omesoftwarelab/RobotArmUsingArduinoUno/Waveform_of_collector_emitter_voltage.jpg

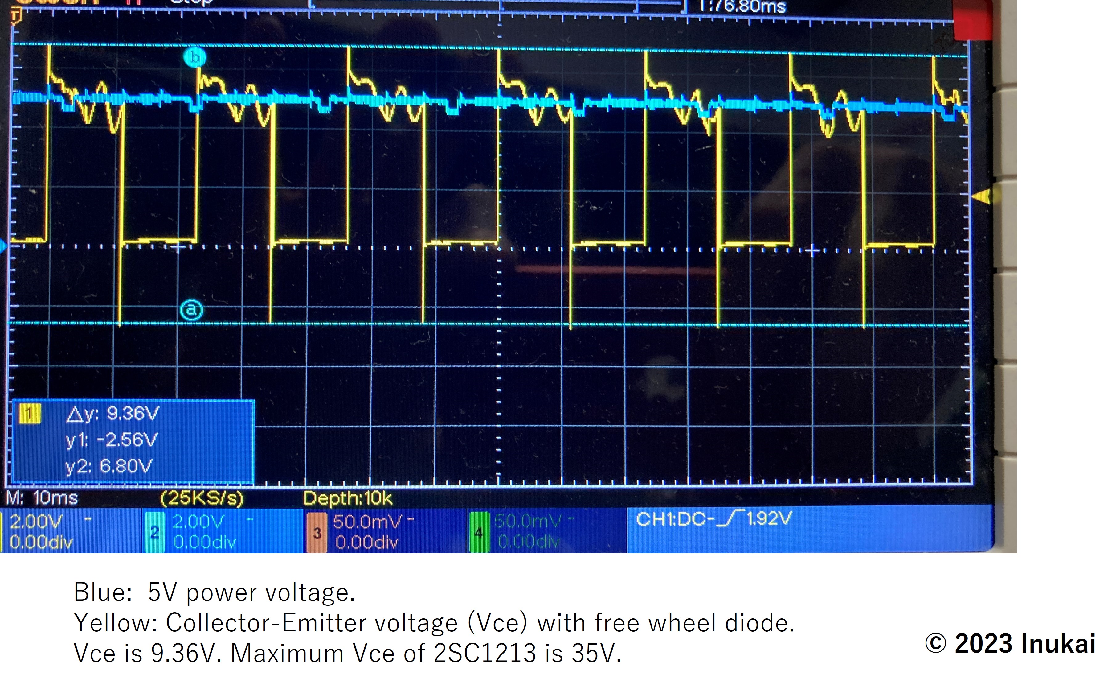
Waveform_of_collector_emitter_voltage.jpg
