omesoftwarelab/RobotArmUsingArduinoUno/ciruit1.jpg

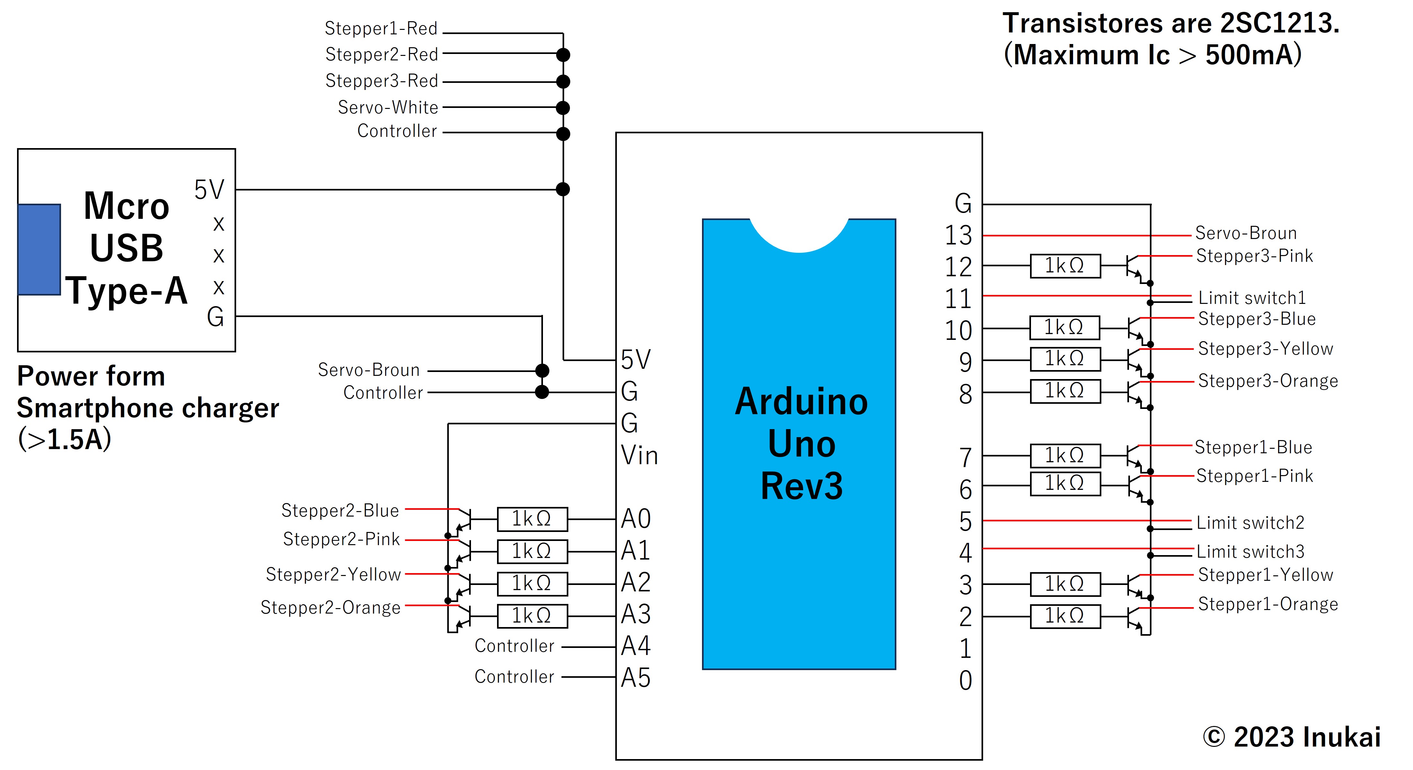
ciruit1.jpg
