omesoftwarelab/RobotArmUsingArduinoUno/ciruit2.jpg

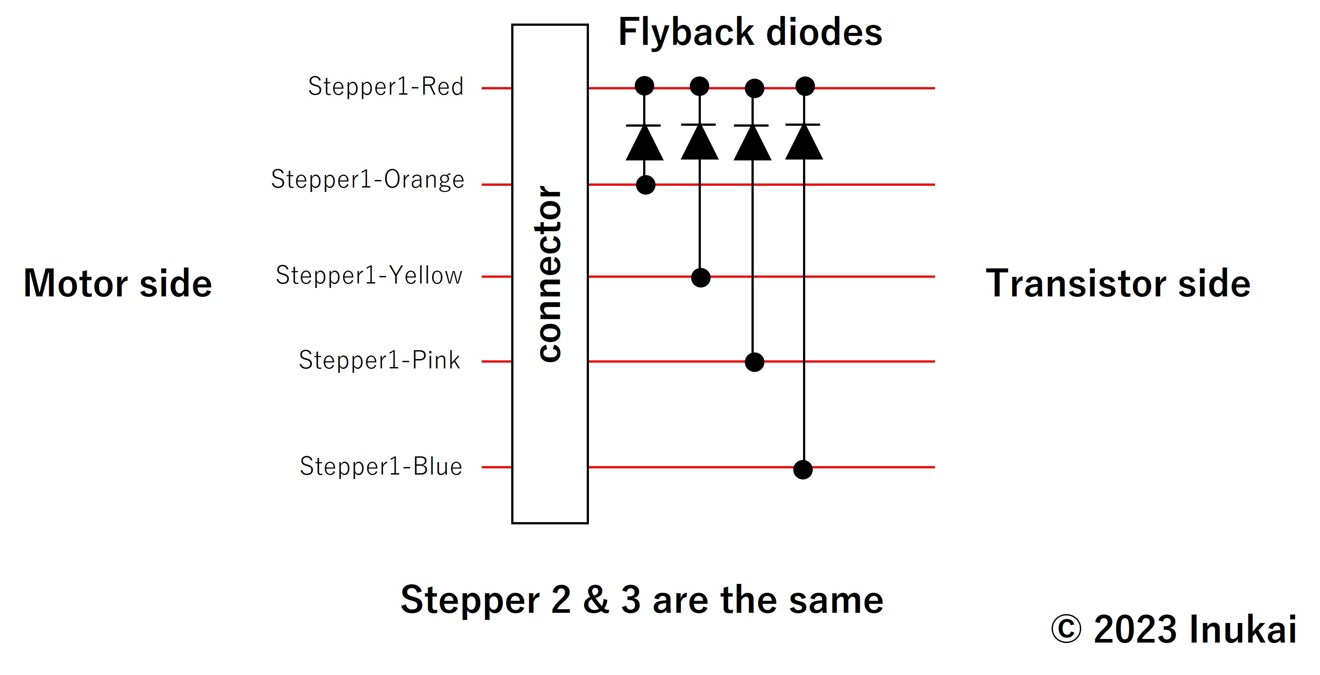
ciruit2.jpg
