omesoftwarelab/RobotArmUsingArduinoUno/ciruit3.jpg

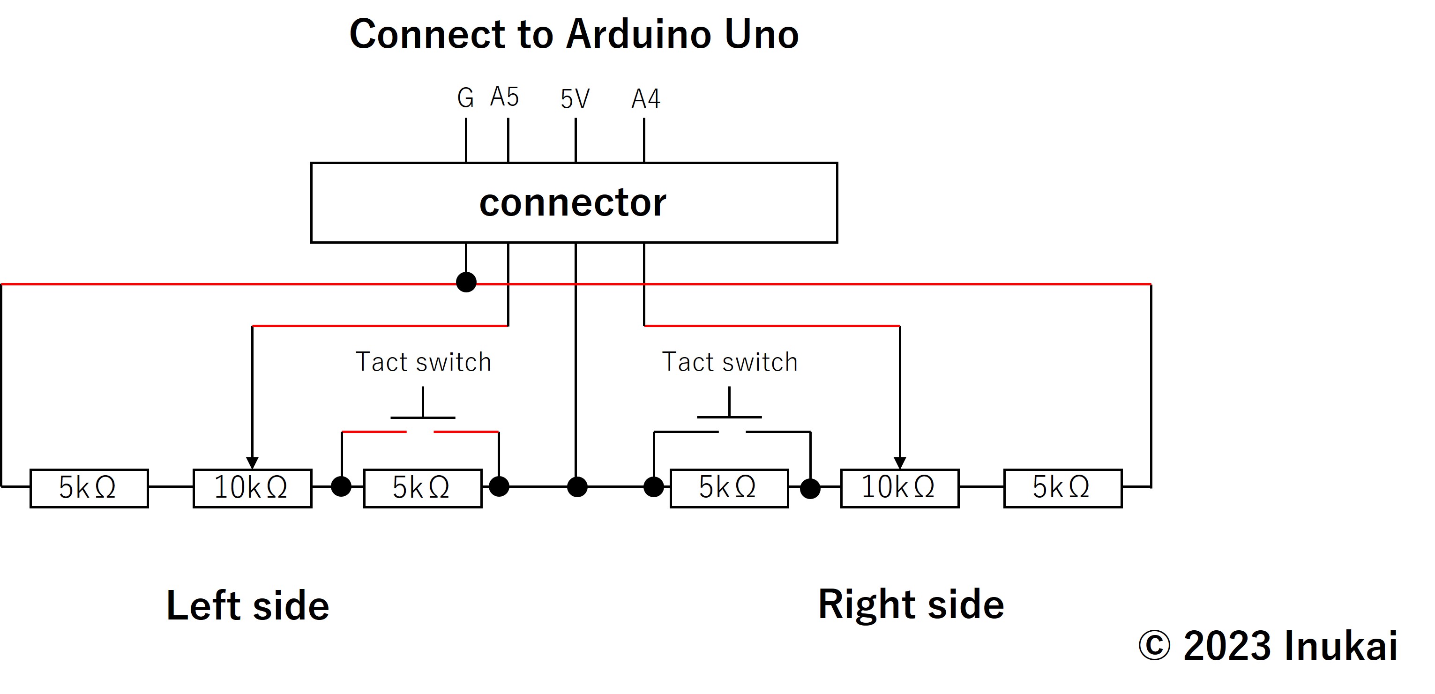
ciruit3.jpg
