omesoftwarelab/RobotArmUsingArduinoUno/(notices)

Notices in the files:
LittleRobotArm.ino:
Copyright (c) 2023 Inukai
